electronut/tinyDriverP/code/2wdbot/README.md

2wdbot.atsln is an Atmel Studio Project.

2wdbot is an obstacle detecting robot based on attiny84 interfaced with an ultrasonic sensor (HCSR04).
An RGB LED is mounted on the chassis which lights up in distinct colours corresponding to the various bot movements.
