electronut/tinyDriverP/tinyDriver.png

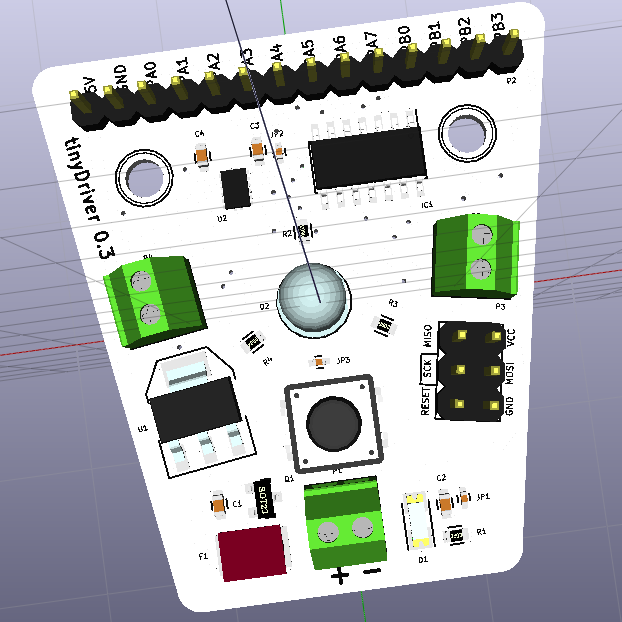
tinyDriver.png
