electronut/tinyDriverP/ver0.3/schematic.pdf

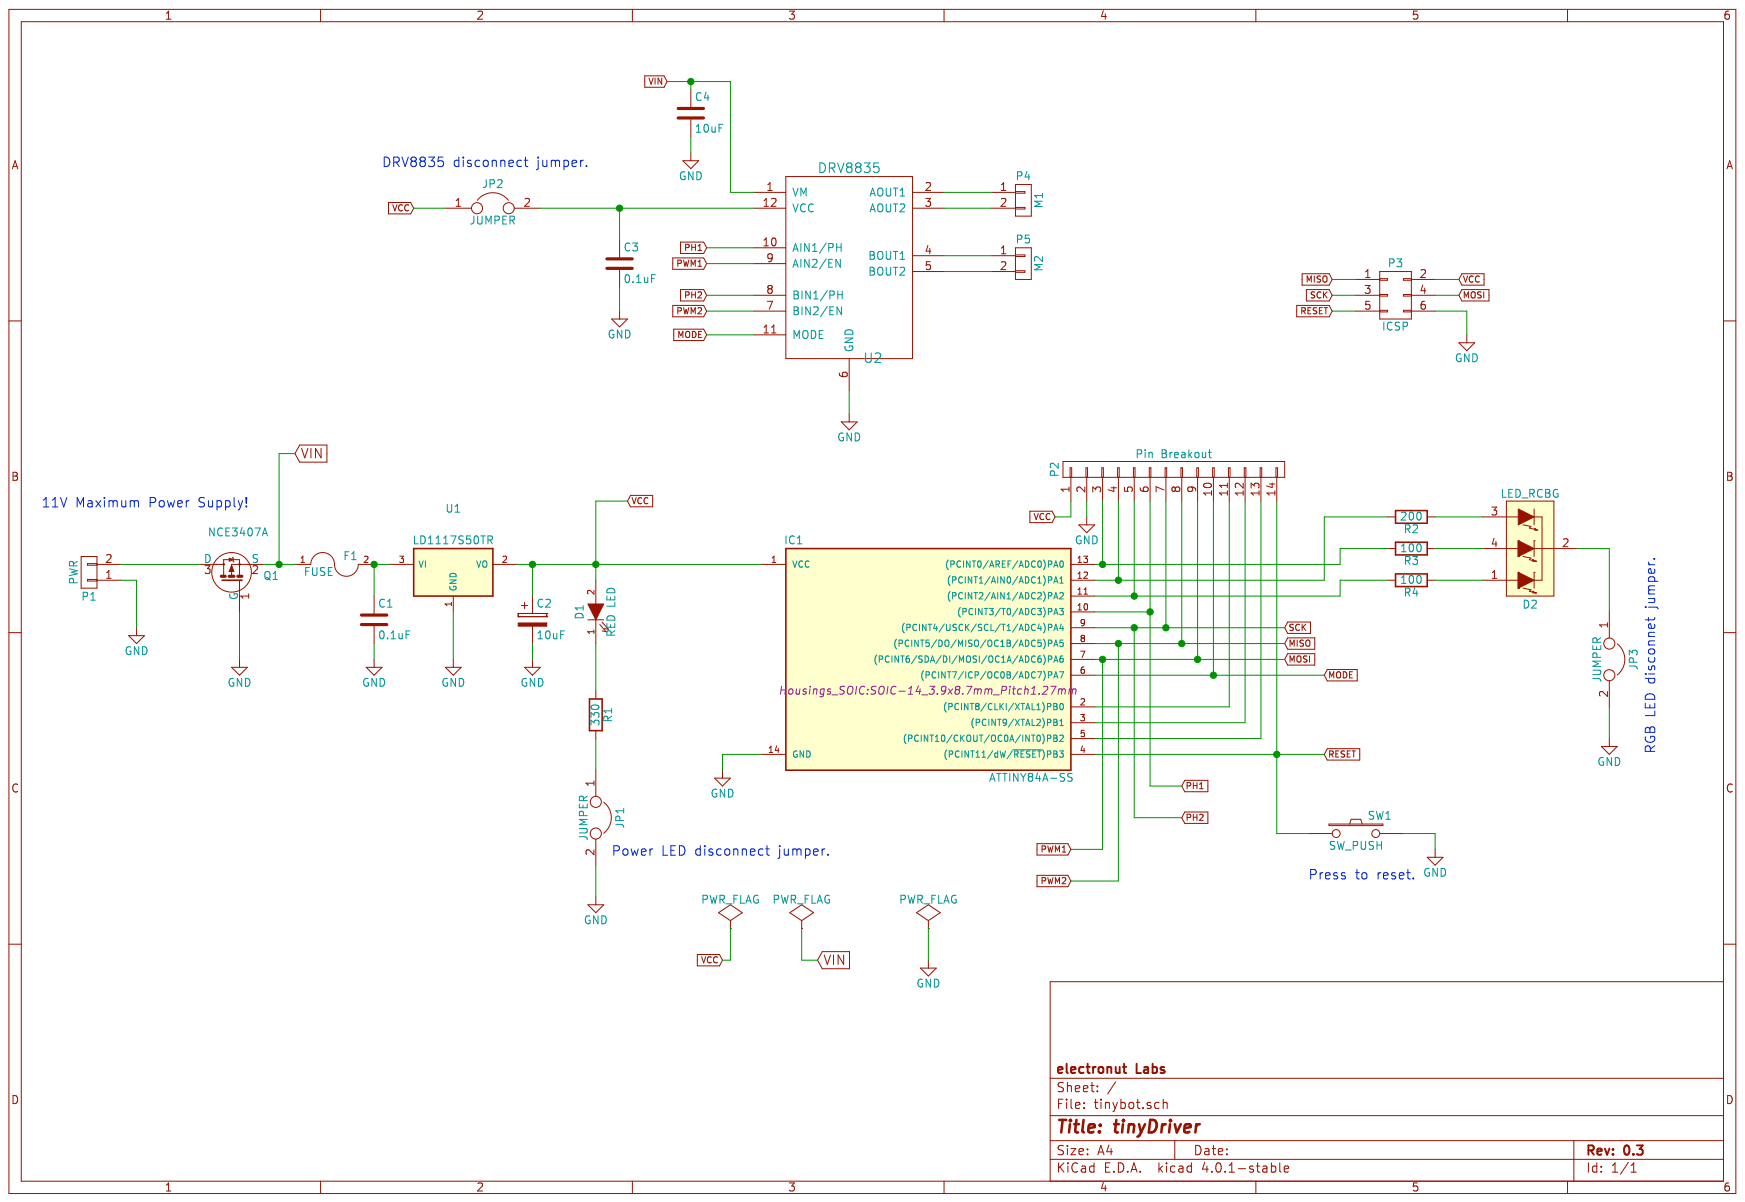
[picture p3: page 1]
