electronut/tinyDriverP/ver0.3/tinybot.kicad_pcb

## KiCad design ver0.3/tinybot.kicad_pcb (2016-04-21)

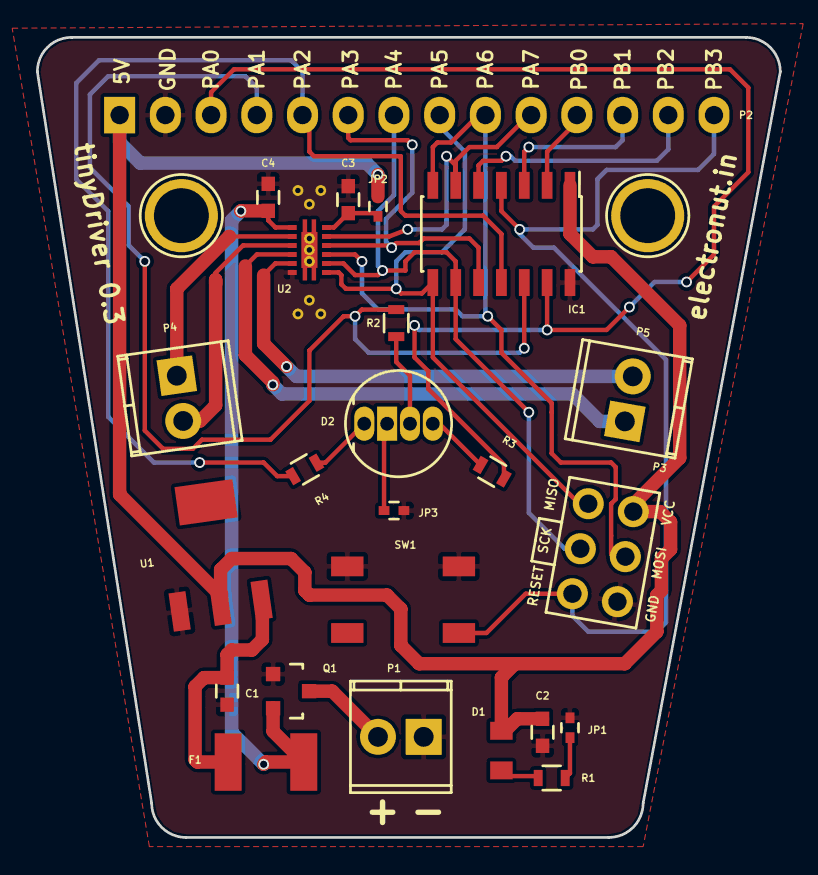
[picture p4: board tinybot.kicad_pcb from above]

Board: 2 copper layers, 41.3 x 44.5 mm, 33 parts (0 on the bottom side), 28 nets.

Parts:
C1, C3: 0.1uF; C_0603
C2, C4: 10uF; C_0603
D1: RED LED; led-0805
D2: LED_RCBG; LED-RGB-5MM_Common_Cathode
F1: FUSE; BOURNS_PTC_FUSE_S1
IC1: ATTINY84A-SS; SOIC-14_3.9x8.7mm_Pitch1.27mm
JP1, JP2, JP3: JUMPER; C_0402
P1: PWR; TerminalBlock_Pheonix_MPT-2.54mm_2pol
P2: Pin Breakout; Pin_Header_Straight_1x14
P3: ICSP; ICSP_2x3
P4: M1; TerminalBlock_Pheonix_MPT-2.54mm_2pol
P5: M2; TerminalBlock_Pheonix_MPT-2.54mm_2pol
Q1: NCE3407A; SOT-23
R1: 330; R_0603
R2: 200; R_0603
R3, R4: 100; R_0603
SW1: SW_PUSH; SWITCH_SKQGAKE010
U1: LD1117S50TR; LD1117_SOT223
U2: DRV8835
via: VAL**; via
via#2, via#3, via#4, via#5, via#6, via#7, via#8, via#9: VAL**; via

Connections:
GND: C1.2, C2.2, C3.2, C4.2, IC1.14, JP1.2, JP3.2, P1.1, P2.2, P3.6, Q1.1, SW1.2, U1.1, U2.6, via.1, via#2.1, via#3.1, via#4.1, via#5.1, via#6.1, via#7.1, via#8.1, via#9.1
MISO: IC1.8, P2.8, P3.1, U2.7
MODE: IC1.6, P2.10, U2.11
MOSI: IC1.7, P2.9, P3.4, U2.9
unnamed: C1.1, F1.2, U1.3
unnamed: C3.1, JP2.2, U2.12
unnamed: D1.1, R1.1
unnamed: D2.1, R4.1
unnamed: D2.2, JP3.1
unnamed: D2.3, R2.1
unnamed: D2.4, R3.1
unnamed: IC1.2, P2.11
unnamed: IC1.3, P2.12
unnamed: IC1.5, P2.13
unnamed: IC1.11, P2.5, R4.2
unnamed: IC1.12, P2.4, R2.2
unnamed: IC1.13, P2.3, R3.2
unnamed: JP1.1, R1.2
unnamed: P1.2, Q1.3
unnamed: P4.1, U2.2
unnamed: P4.2, U2.3
unnamed: P5.1, U2.4
unnamed: P5.2, U2.5
PH1: IC1.10, P2.6, U2.10
PH2: IC1.9, P2.7, P3.3, U2.8
RESET: IC1.4, P2.14, P3.5, SW1.1
VCC: C2.1, D1.2, IC1.1, JP2.1, P2.1, P3.2, U1.2
VIN: C4.1, F1.1, Q1.2, U2.1
